evandro-teixeira/coreduino/Documentos/pcbCOREDuino.jpg

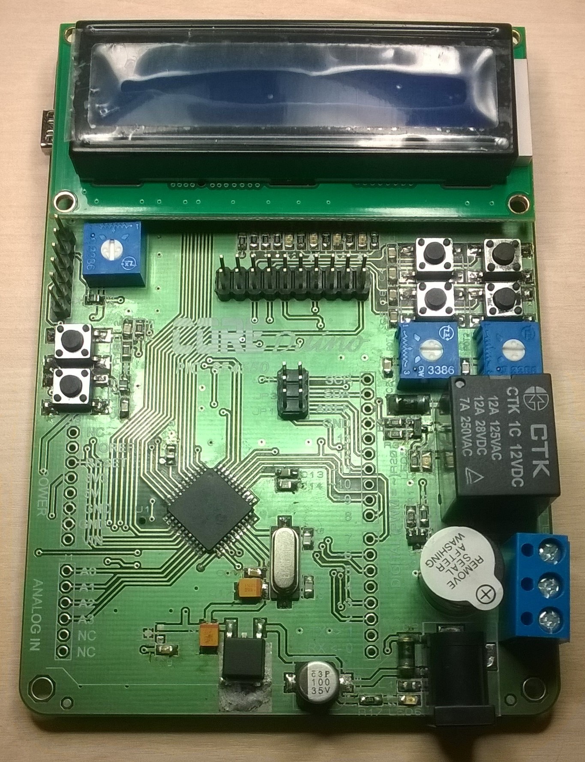
Documentos/pcbCOREDuino.jpg
