evandro-teixeira/coreduino/README.md

# COREDuino
O COREduino é Kit de desenvolvimento Open Hardware baseado no Arduino e no Pinguino com o microcontroladores PIC18F4550, esse kit diferente do Arduino e do Pinguino já conta com diversos periféricos em seu hardware. Possibilitando assim aos seus usuários colocar em pratica diversos conceitos de eletrônica e programação, sem necessidade de um circuito externo.
Mais Informações sobre o Projeto Pinguino no Link:
http://www.pinguino.cc/

#O hardware
O Hardwaredo COREduino conta com o microcontrolador PIC18F4550 da Microchip. É microcontrolador de 8 bit que possui 32 kB de memoria Flash, 2 kB de memoria RAM, com Clock máximo de 48MHz e ADC de 10 bit. 
A placa do COREduino possui diversos periféricos que auxiliam no desenvolvimento de aplicações. A seguir são apresentados os recursos presentes na placa:

•	Gravador On-Board (USB).

•	Barramento para ICSP (Gravador Externo).

•	Display de LCD 16×2.

•	Entradas Analógicas conectados em Trimpots.

•	Buzzer.

•	USB 2.0: permite que façam programas sofisticados comunicando via canal USB 2.0.

•	Relê NA/NF.

•	Fonte Alimentação: Externa ou USB.

•	Push-Button.

#Licença
Como dito acima o COREduino trata-se um projeto Open Hardware, o projeto da placa foi desenvolvido e publicado sob a licença Creative Commons Attribution-ShareAlike 4.0 International Public License.

http://coretools.com.br/site/educacionais/

https://www.embarcados.com.br/coreduino-pic18f4550/
