evandro-teixeira/coreduino/Hardware/Rev_00/bottom silk.pdf

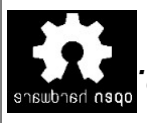
[picture p7: figure]
