evandro-teixeira/coreduino/Exemplos/hello word/doc/imagens/CE COREDuino.jpg

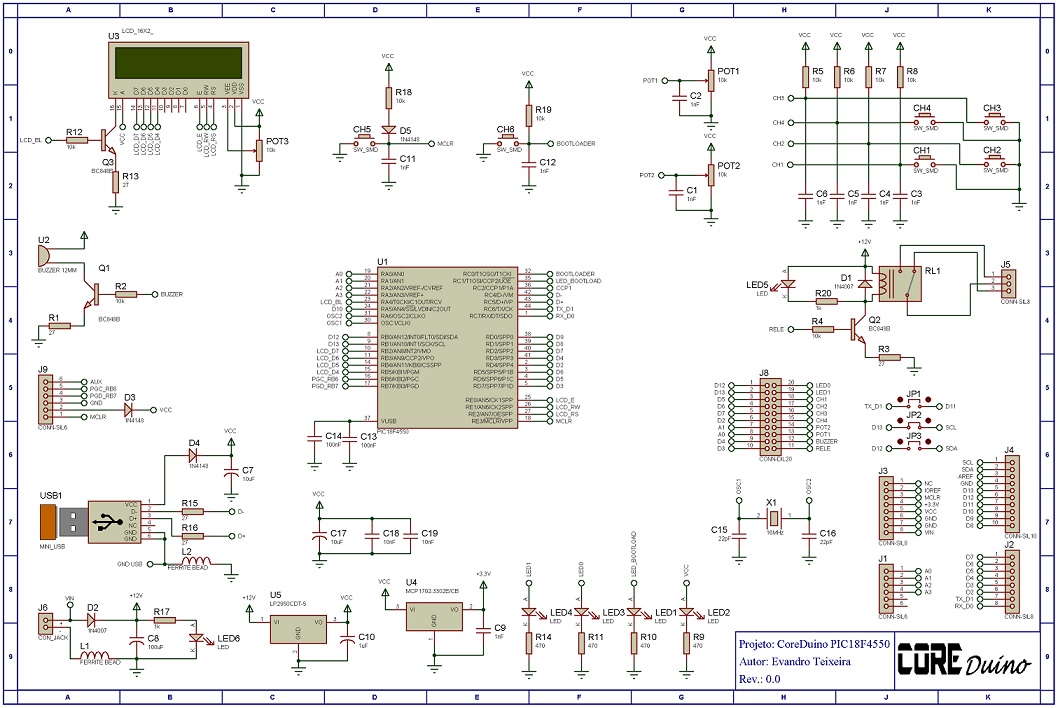
Exemplos/hello word/doc/imagens/CE COREDuino.jpg
