evandro-teixeira/coreduino/Exemplos/hello word/doc/imagens/Imagem0.png

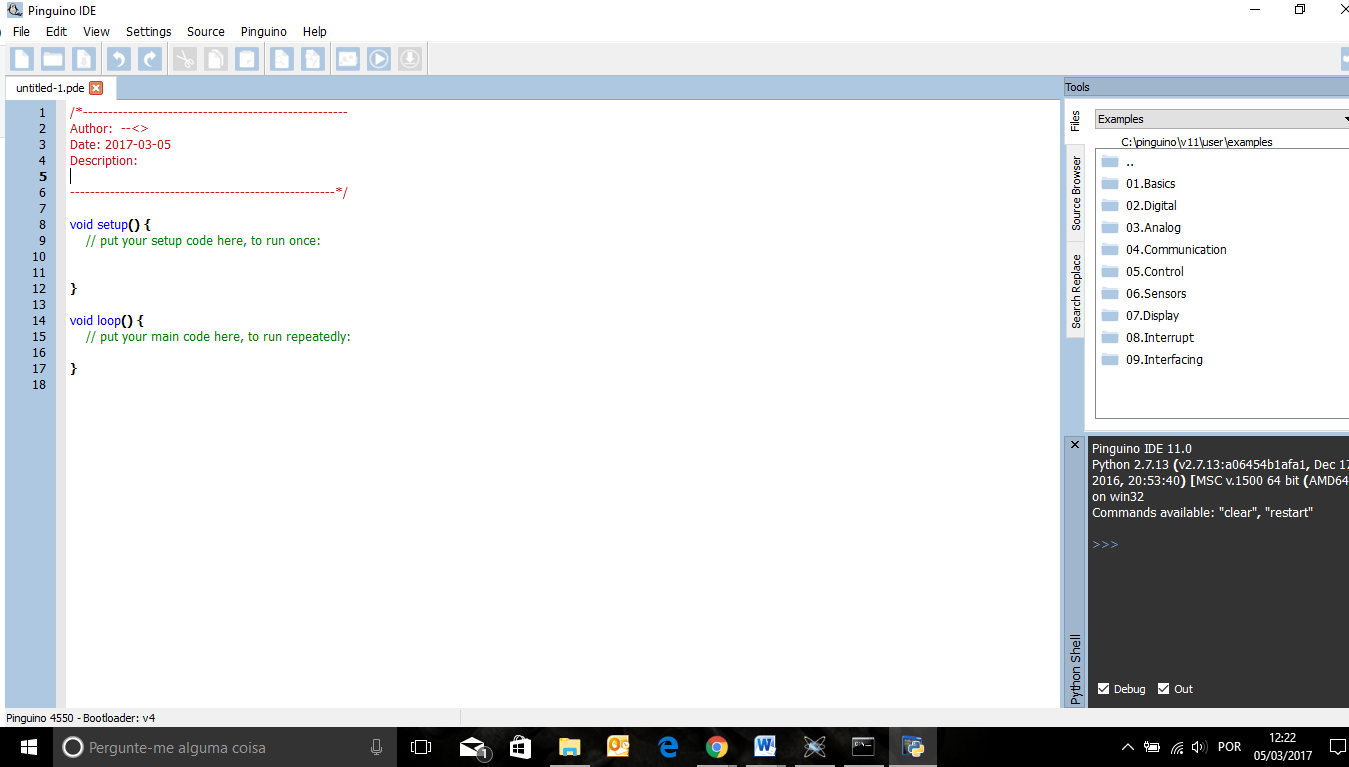
Exemplos/hello word/doc/imagens/Imagem0.png
