evandro-teixeira/coreduino/Exemplos/hello word/doc/imagens/Imagem1.png

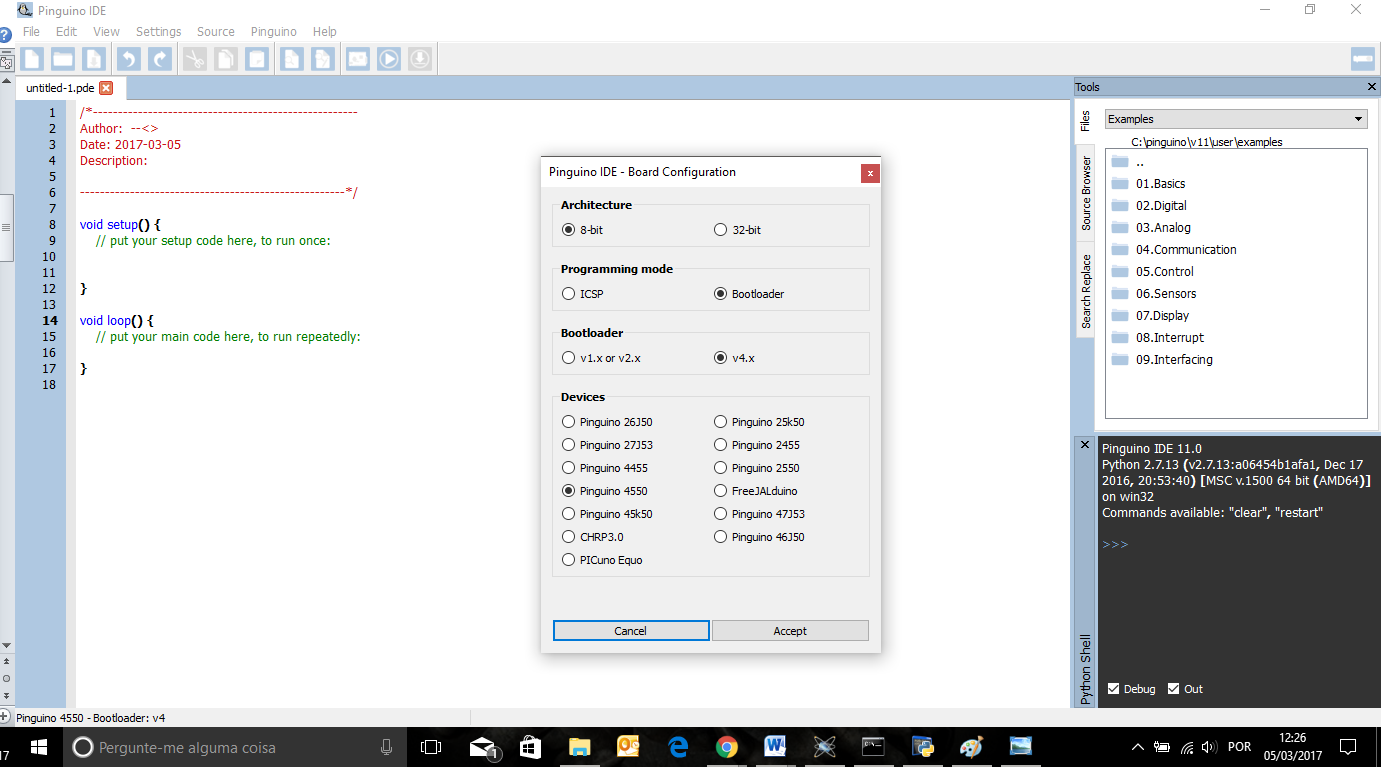
Exemplos/hello word/doc/imagens/Imagem1.png
