evandro-teixeira/coreduino/Exemplos/hello word/doc/imagens/Imagem2.png

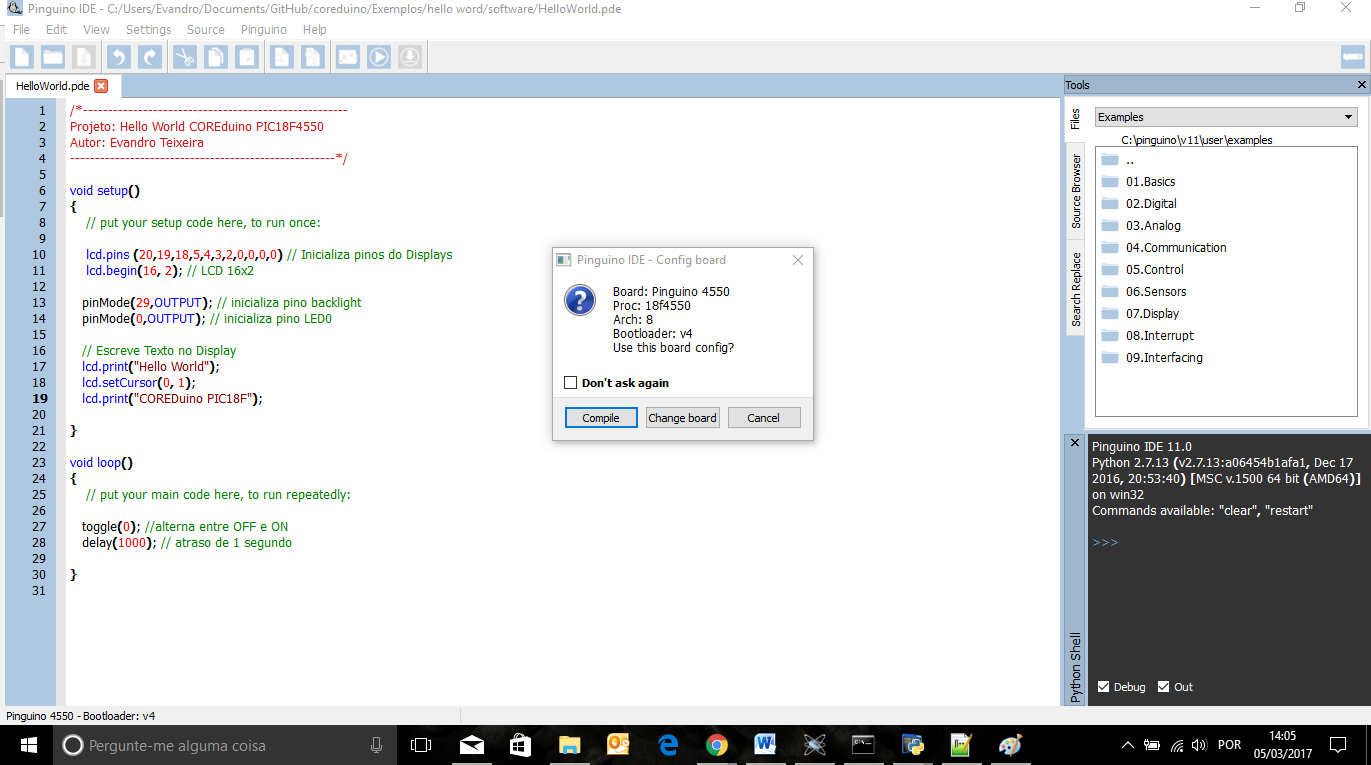
Exemplos/hello word/doc/imagens/Imagem2.png
