evandro-teixeira/coreduino/Exemplos/hello word/doc/imagens/Imagem3.png

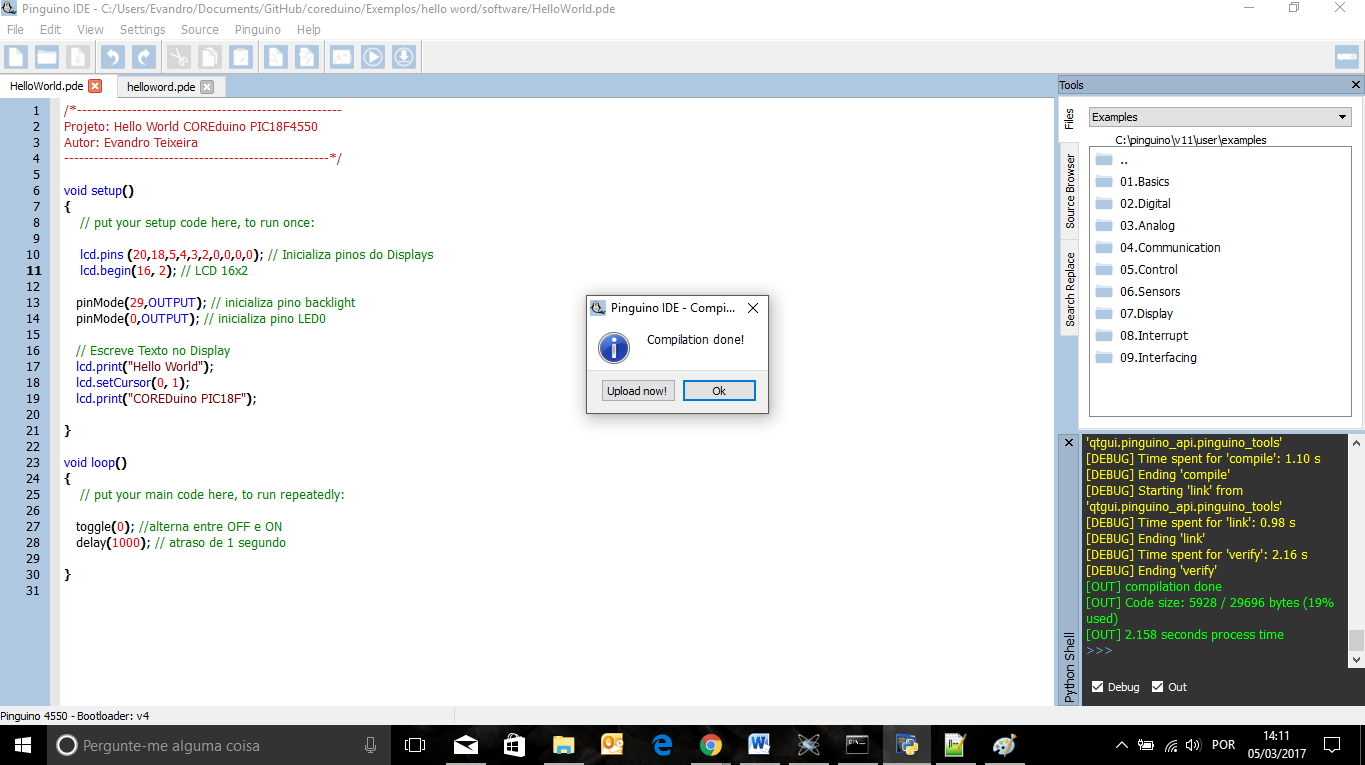
Exemplos/hello word/doc/imagens/Imagem3.png
