evandro-teixeira/coreduino/Exemplos/hello word/doc/imagens/Imagem6.png

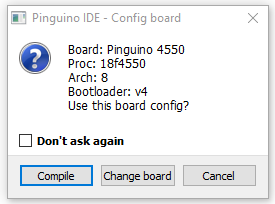
Exemplos/hello word/doc/imagens/Imagem6.png
