evandro-teixeira/coreduino/Exemplos/hello word/doc/imagens/Imagem7.png

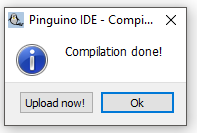
Exemplos/hello word/doc/imagens/Imagem7.png
