evandro-teixeira/coreduino/Exemplos/hello word/doc/imagens/Imagem8.png

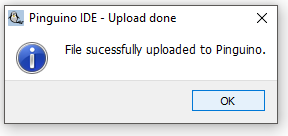
Exemplos/hello word/doc/imagens/Imagem8.png
