evandro-teixeira/coreduino/Exemplos/hello word/doc/imagens/Imagem9.png

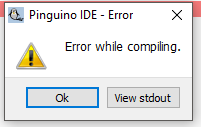
Exemplos/hello word/doc/imagens/Imagem9.png
