evandro-teixeira/coreduino/Exemplos/hello word/doc/imagens/Imagem10.png

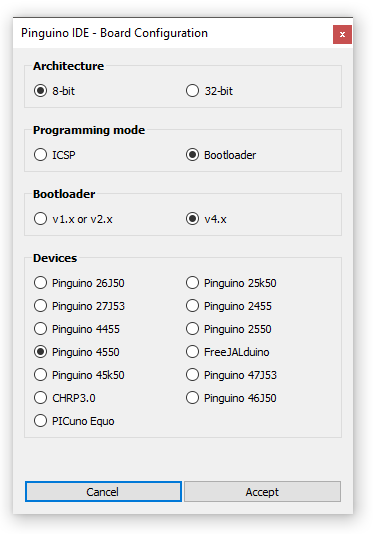
Exemplos/hello word/doc/imagens/Imagem10.png
