evandro-teixeira/coreduino/Exemplos/hello word/doc/imagens/imagemdestaque.png

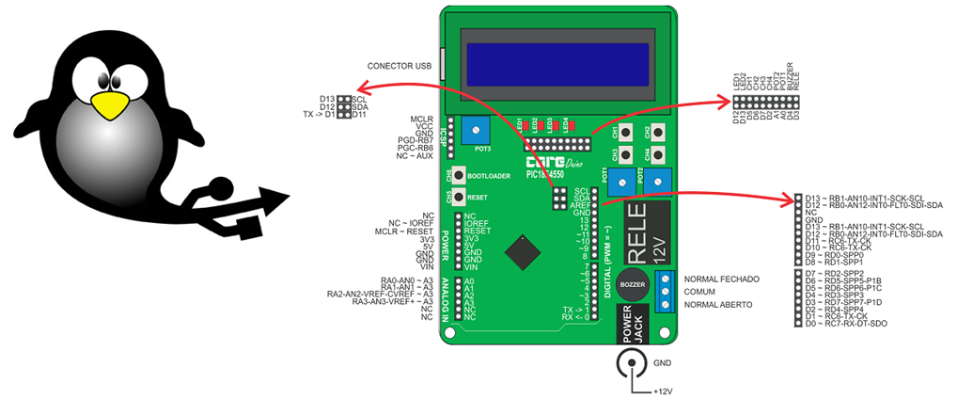
Exemplos/hello word/doc/imagens/imagemdestaque.png
