evandro-teixeira/coreduino/Exemplos/motor de passo/doc/COREduino_PIC_Motor_de_Passo.png

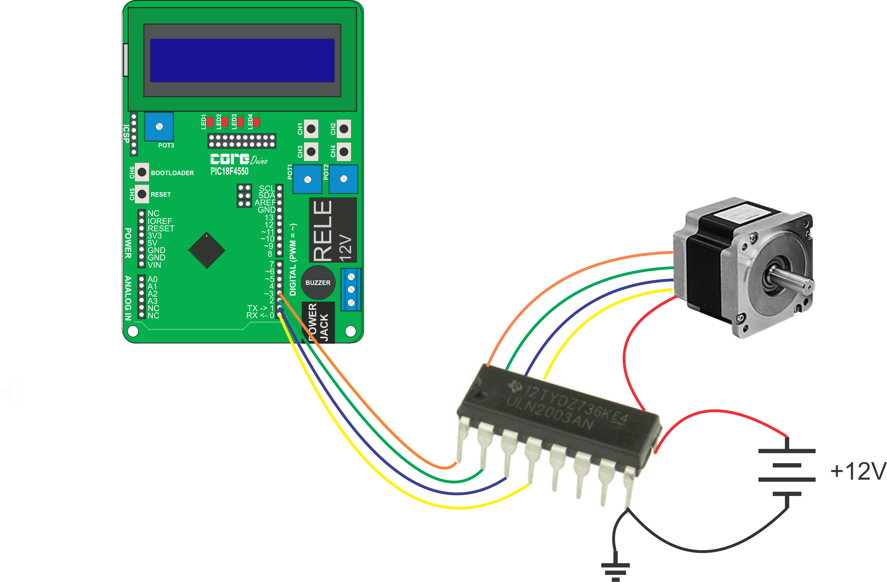
Exemplos/motor de passo/doc/COREduino_PIC_Motor_de_Passo.png
