evandro-teixeira/coreduino/Documentos/COREDuino Bill Of Materials.html

Design Title | COREDuino PIC18F4550
Author | Evandro Teixeira
Document Number
Revision | Rev.:0.0
Total Parts In Design | 83
COREtools.com.br (http://coretools.com.br/site/)
0 Modules
Quantity | References | Value | Stock Code | Unit Cost
Sub-totals: |  |  |  | R$0,00
19 Capacitors
Quantity | References | Value | Stock Code | Unit Cost
9 | C1,C2,C3,C4,C5,C6,C9,C11,C12 | 1nF
2 | C7,C17 | 10uF
1 | C8 | 100uF
1 | C10 | 1uF
2 | C13,C14 | 100nF
2 | C15,C16 | 22pF
2 | C18,C19 | 10nF
Sub-totals: |  |  |  | R$0,00
20 Resistors
Quantity | References | Value | Stock Code | Unit Cost
5 | R1,R3,R13,R15,R16 | 27
9 | R2,R4,R5,R6,R7,R8,R12,R18,R19 | 10k
4 | R9,R10,R11,R14 | 470
2 | R17,R20 | 1k
Sub-totals: |  |  |  | R$0,00
5 Integrated Circuits
Quantity | References | Value | Stock Code | Unit Cost
1 | U1 | PIC18F4550
1 | U2 | BUZZER 12MM
1 | U3 | LCD_16X2_
1 | U4 | MCP1702-3302E/CB
1 | U5 | LP2950CDT-5
Sub-totals: |  |  |  | R$0,00
3 Transistors
Quantity | References | Value | Stock Code | Unit Cost
3 | Q1,Q2,Q3 | BC848B
Sub-totals: |  |  |  | R$0,00
5 Diodes
Quantity | References | Value | Stock Code | Unit Cost
2 | D1,D2 | 1N4007
3 | D3,D4,D5 | 1N4148
Sub-totals: |  |  |  | R$0,00
31 Miscellaneous
Quantity | References | Value | Stock Code | Unit Cost
6 | CH1,CH2,CH3,CH4,CH5,CH6 | SW_SMD
2 | J1,J9 | CONN-SIL6
2 | J2,J3 | CONN-SIL8
1 | J4 | CONN-SIL10
1 | J5 | CONN-SIL3
1 | J6 | CON_JACK
1 | J8 | CONN-DIL20
3 | JP1,JP2,JP3 | JUMPER
2 | L1,L2 | FERRITE BEAD
6 | LED1,LED2,LED3,LED4,LED5,LED6 | LED
3 | POT1,POT2,POT3 | 10k
1 | RL1 | G5CLE-1-DC12
1 | USB1 | MINI_USB
1 | X1 | 16MHz
Sub-totals: |  |  |  | R$0,00
Totals: |  |  |  | R$0,00
