evandro-teixeira/coreduino/Hardware/Rev_01/BOM COREDUINO PIC18F4550.xlsx

Bill Of Materials for
Projeto | COREDUINO PIC18F45450
Category | Quantity | References | Part Number/Value | Valor Unitario | Valor Total | Fornecedor
Capacitors | 10 | C1,C2,C3,C4,C5,C6,C11,C12,C20,C21 | 1nF | R$0.15 | R$1.50 | http://www.eletrodex.com.br/
Capacitors | 2 | C7,C17 | 10uF | R$0.57 | R$1.14 | http://www.powercircuit.com.br/
Capacitors | 1 | C8 | 100uF | R$0.78 | R$0.78
Capacitors | 3 | C13,C14,C22 | 100nF | R$0.15 | R$0.45
Capacitors | 2 | C15,C16 | 22pF | R$0.10 | R$0.20
Capacitors | 2 | C18,C19 | 10nF | R$0.10 | R$0.20
Capacitors | 1 | C23 | 330nF | R$0.10 | R$0.10
Resistors | 5 | R1,R3,R13,R15,R16 | 27 | R$0.05 | R$0.25
Resistors | 9 | R2,R4,R5,R6,R7,R8,R12,R18,R19 | 10k | R$0.05 | R$0.45
Resistors | 4 | R9,R10,R11,R14 | 470 | R$0.05 | R$0.20
Resistors | 2 | R17,R20 | 1k | R$0.05 | R$0.10
Integrated Circuits | 1 | U1 | PIC18F4550 | R$49.09 | R$49.09
Integrated Circuits | 1 | U2 | BUZZER 12MM | R$1.87 | R$1.87
Integrated Circuits | 1 | U3 | LCD_16X2_ | R$42.09 | R$42.09
Integrated Circuits | 1 | U6 | 7805 | R$1.69 | R$1.69
Integrated Circuits | 1 | U7 | LM1117MPX-33 | R$1.97 | R$1.97
Transistors | 3 | Q1,Q2,Q3 | BC848B | R$0.13 | R$0.39
Diodes | 2 | D1,D2 | 1N4007 | R$0.10 | R$0.20
Diodes | 3 | D3,D4,D5 | 1N4148 | R$0.10 | R$0.30
Miscellaneous | 6 | CH1,CH2,CH3,CH4,CH5,CH6 | SW_SMD | R$0.20 | R$1.20
Miscellaneous | 2 | J1,J9 | CONN-SIL6 | R$0.50 | R$1.00
Miscellaneous | 2 | J2,J3 | CONN-SIL8 | R$0.50 | R$1.00
Miscellaneous | 1 | J4 | CONN-SIL10 | R$0.50 | R$0.50
Miscellaneous | 1 | J5 | CONN-SIL3 | R$1.13 | R$1.13
Miscellaneous | 1 | J6 | CON_JACK | R$1.05 | R$1.05
Miscellaneous | 1 | J8 | CONN-DIL20 | R$0.50 | R$0.50
Miscellaneous | 3 | JP1,JP2,JP3 | JUMPER | R$0.15 | R$0.45
Miscellaneous | 2 | L1,L2 | FERRITE BEAD | R$0.26 | R$0.52
Miscellaneous | 6 | LED1,LED2,LED3,LED4,LED5,LED6 | LED | R$0.35 | R$2.10
Miscellaneous | 3 | POT1,POT2,POT3 | 10k | R$1.15 | R$3.45
Miscellaneous | 1 | RL1 | G5CLE-1-DC12 | R$3.78 | R$3.78
Miscellaneous | 1 | USB1 | MINI_USB | R$2.89 | R$2.89
Miscellaneous | 1 | X1 | 16MHz | R$0.61 | R$0.61
pci | 1 |  |  | 25 | 25
Total |  |  |  |  | R$148.15
