evandro-teixeira/coreduino/Documentos/coreduino pic18f4550 circuito elétrico.pdf

CH3

CH2

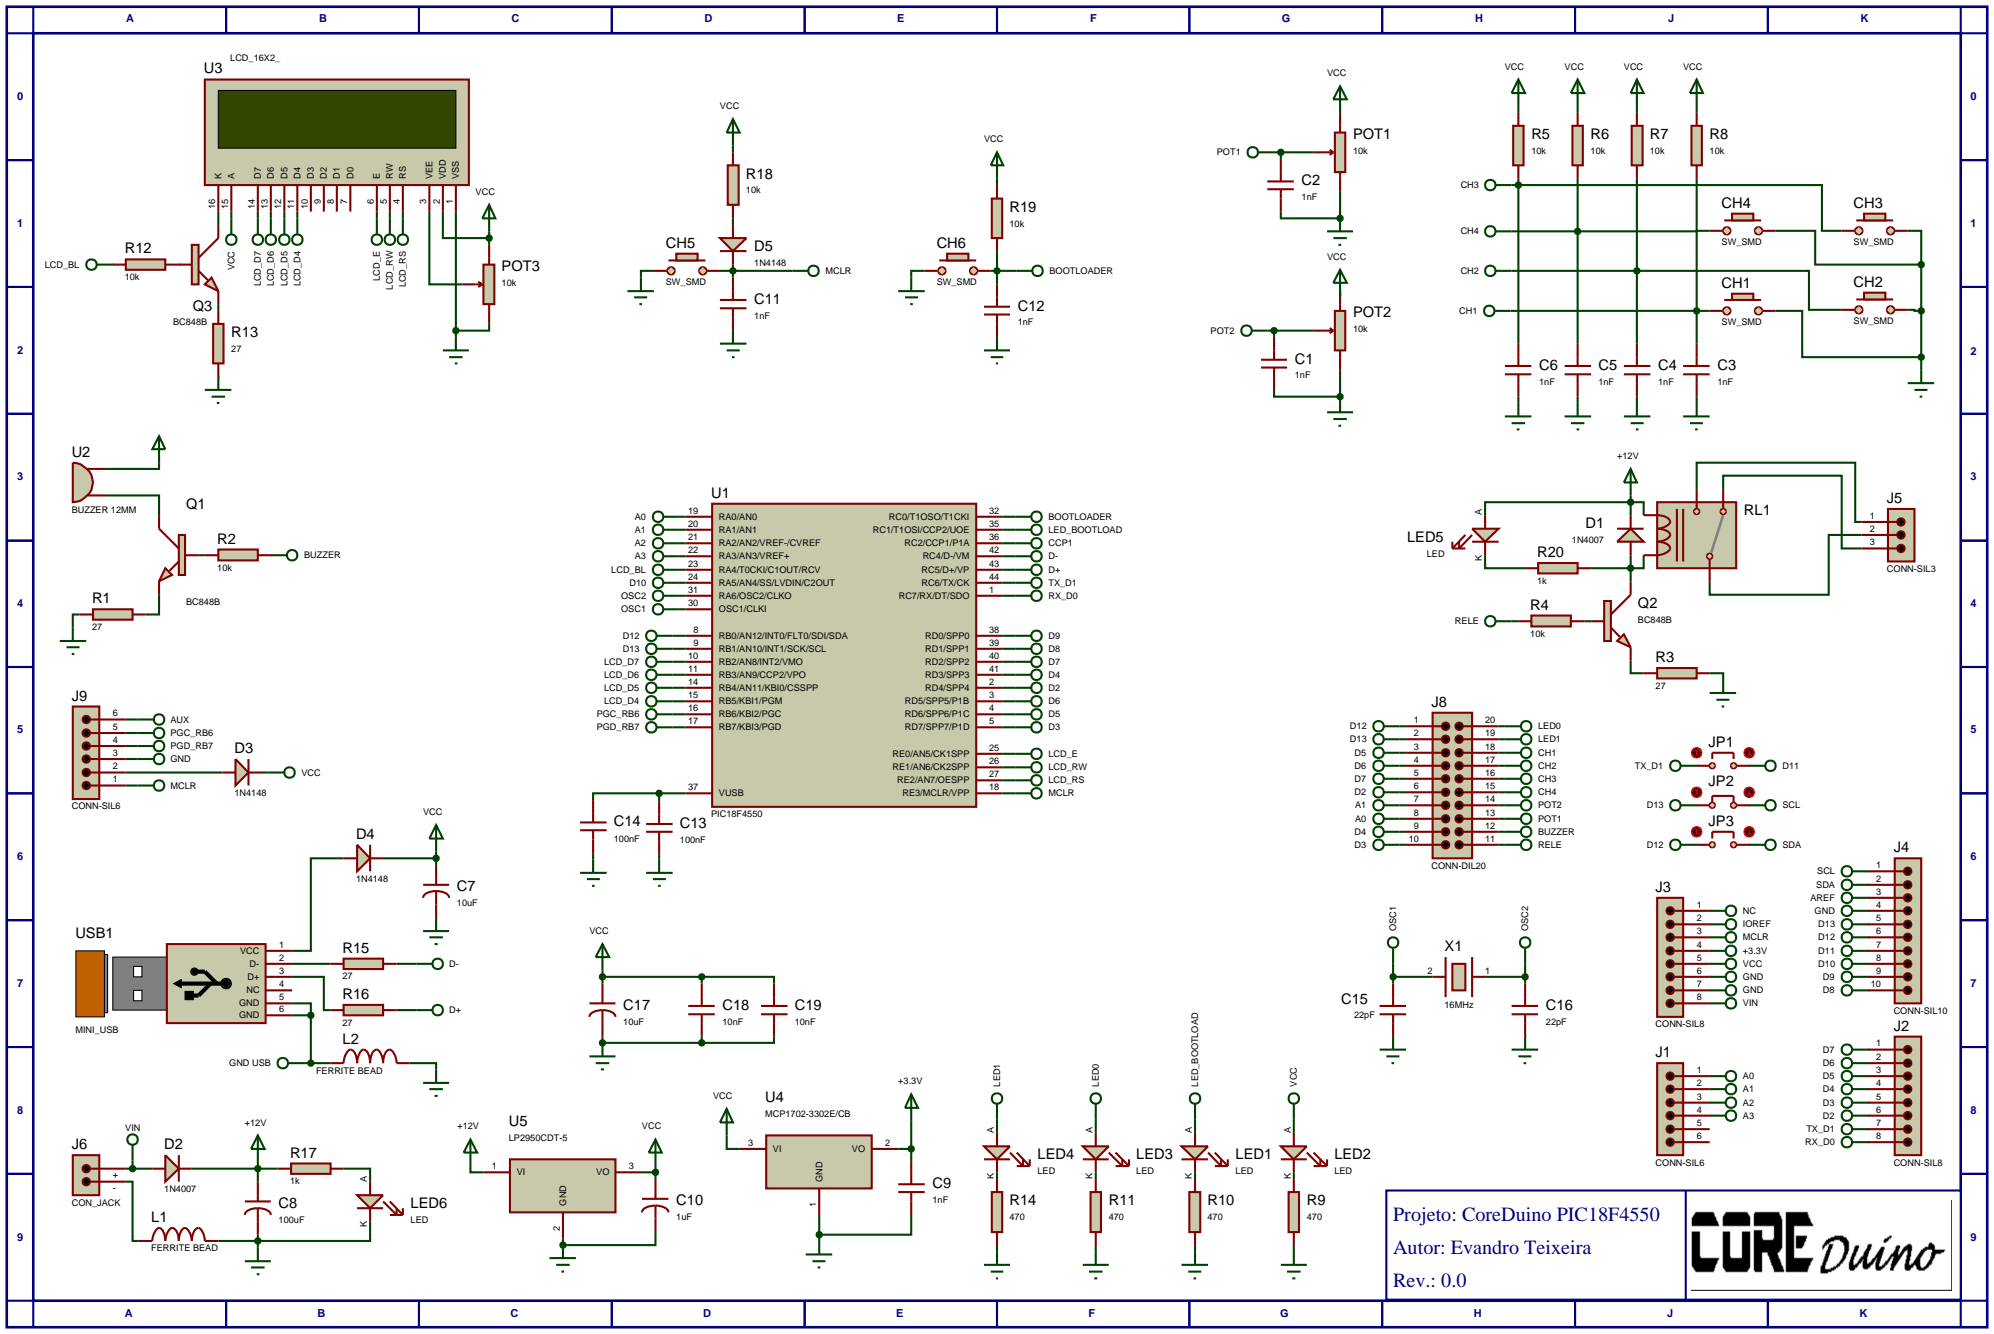
[picture p20: page 1]
