evandro-teixeira/coreduino/Hardware/Rev_00/top silk.pdf

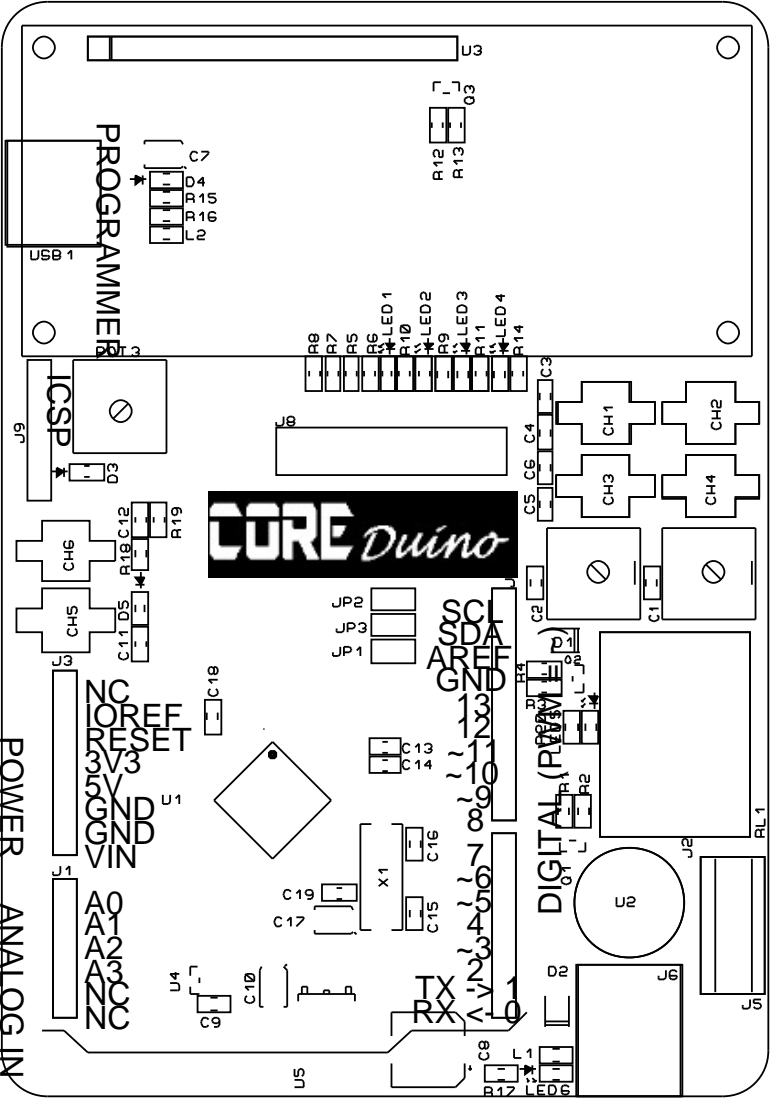
[picture p21: page 1]
NCIOREF; 3V3 5VGND GND; VIN; RESET; A0A1 A2 A3NCNC; GND AREF; DIGITAL (PWM = ~); PROGRAMMER; SCL SDA; ICSP

POWER ANALOG IN
