evandro-teixeira/coreduino/Hardware/Rev_00/bottom copper.pdf

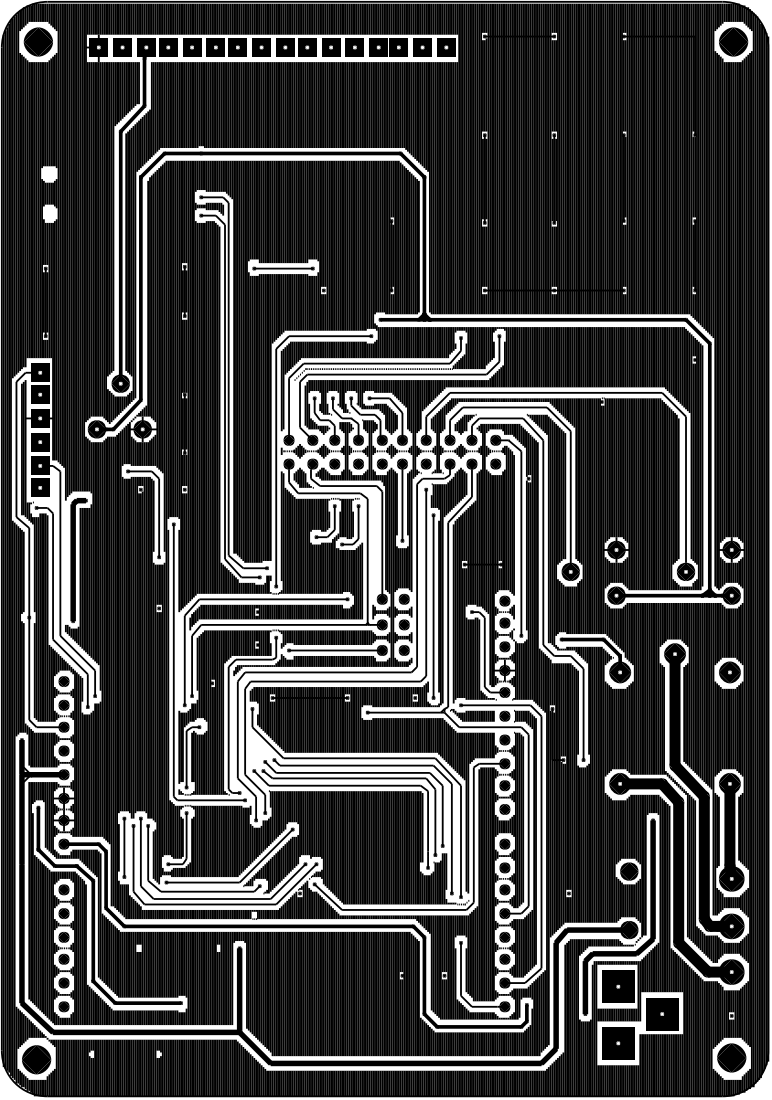
[picture p22: page 1]
