evandro-teixeira/coreduino/Hardware/Rev_00/top copper.pdf

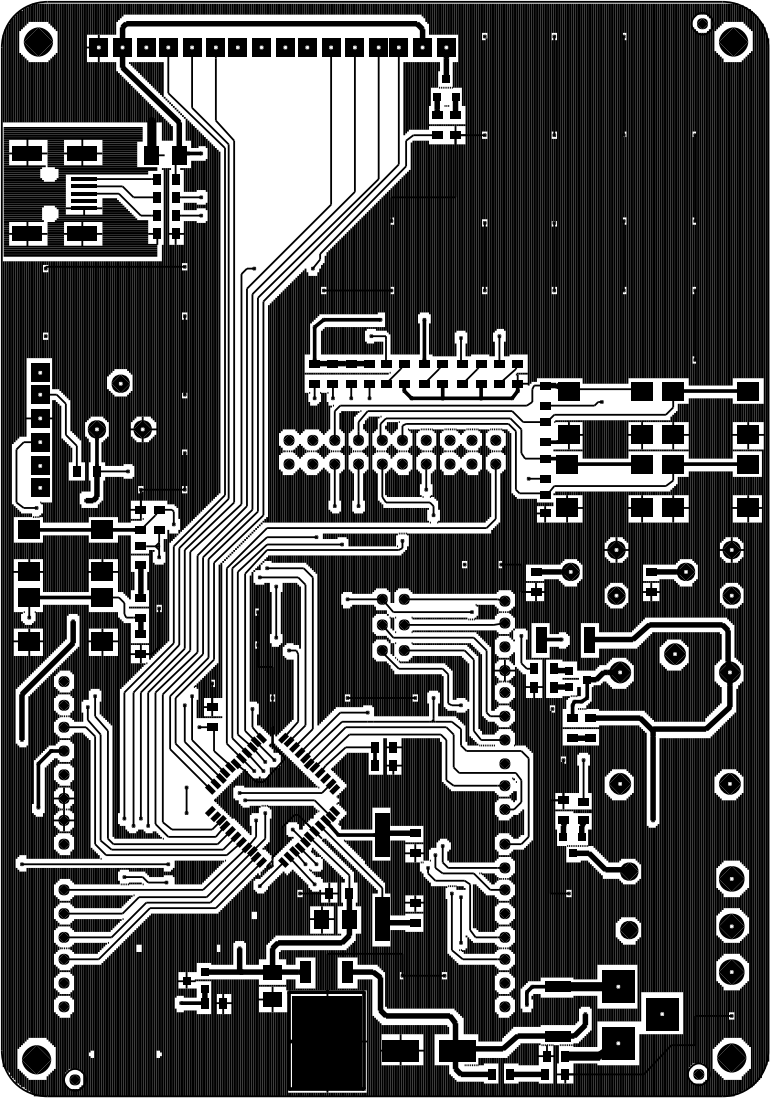
[picture p23: page 1]
