evandro-teixeira/coreduino/(list of files, drawings)

Other design files:
Hardware/Rev_00/coreduino_pic18f4550.pdsprj
Hardware/Rev_01/coreduino_pic18f4550_rev01.pdsprj
