evandro-teixeira/coreduino/(commit log)

2017-02-14 Uploading Filies
    Uploading Filies
    [coreduino_pic18f4550.pdsprj]
2017-03-19 Rev01
    Arquivos Rev01
    [BOM COREDUINO PIC18F4550.xlsx, coreduino_pic18f4550.pdsprj, coreduino_pic18f4550_rev01.pdsprj]
2017-03-19 Rev_01
    Arquivos Rev_01
    [coreduino_pic18f4550_rev01.pdsprj]
